NQAnh2425/SmartGarden/smart_garden_report/document/z7949874672636_2bea79ddac5231fc07fe2b95ad121b33.jpg

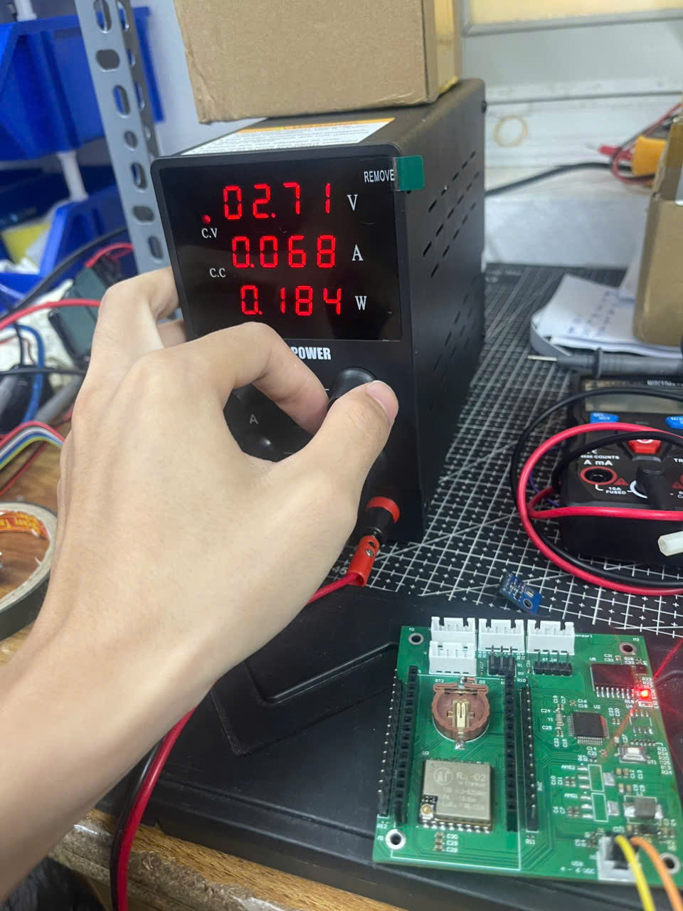
smart_garden_report/document/z7949874672636_2bea79ddac5231fc07fe2b95ad121b33.jpg
