NQAnh2425/SmartGarden/smart_garden_report/document/z7949874676888_7535db27ef83c04990b1f25cf6fda284.jpg

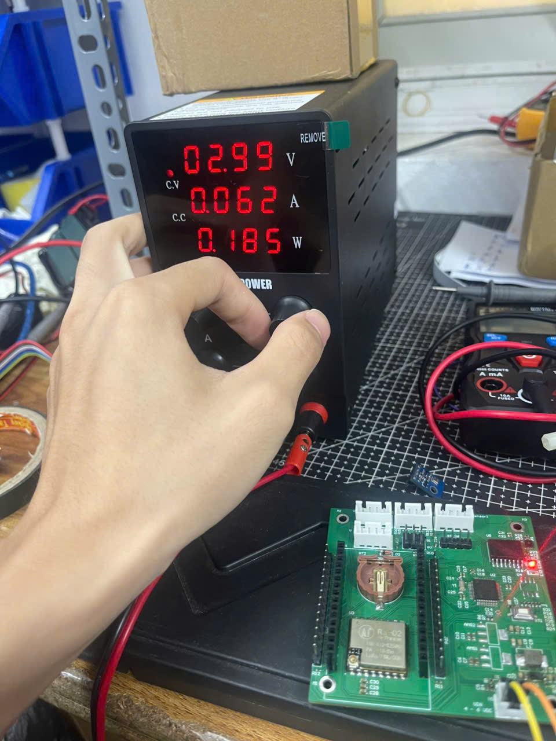
smart_garden_report/document/z7949874676888_7535db27ef83c04990b1f25cf6fda284.jpg
