NQAnh2425/SmartGarden/smart_garden_report/document/z7949874697322_e2b428432fa8df952e352a67de80ceb8.jpg

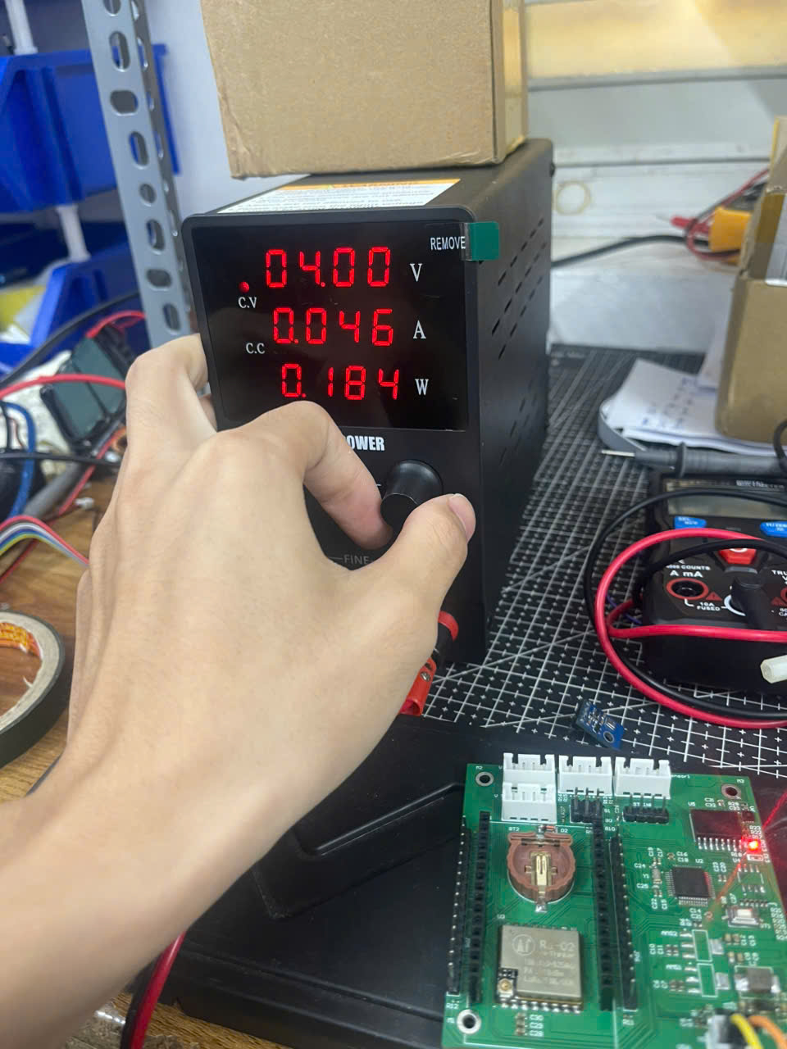
smart_garden_report/document/z7949874697322_e2b428432fa8df952e352a67de80ceb8.jpg
