NQAnh2425/SmartGarden/smart_garden_report/document/z7949874712150_3ca1921e6f091ef7c55d4dc10afe0f25.jpg

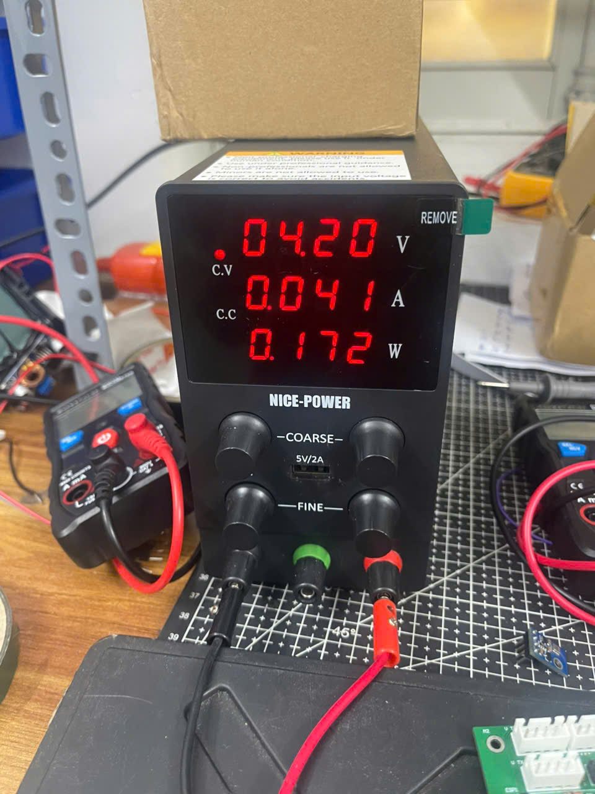
smart_garden_report/document/z7949874712150_3ca1921e6f091ef7c55d4dc10afe0f25.jpg
