NQAnh2425/SmartGarden/smart_garden_report/document/z7949874716990_c0b9dc836de0033d741a48ff5960702d.jpg

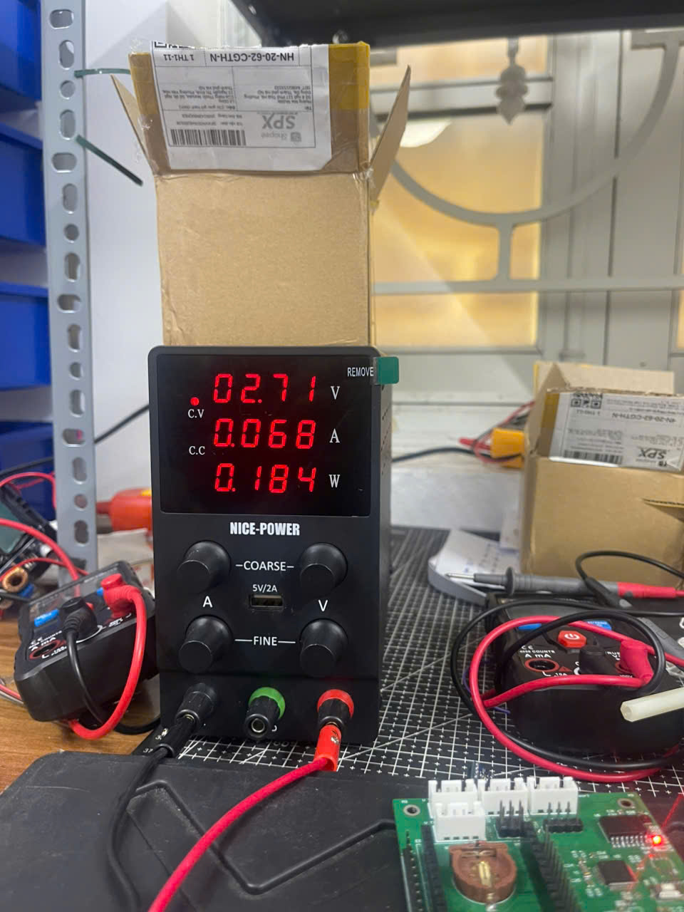
smart_garden_report/document/z7949874716990_c0b9dc836de0033d741a48ff5960702d.jpg
