NQAnh2425/SmartGarden/smart_garden/Node/Core/Src/main.c

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
/* Includes ------------------------------------------------------------------*/
#include "main.h"

/* USER CODE BEGIN Includes */
#include "string.h"
#include "SHT30.h"
#include "LoRa.h"
#include "LoRa_network.h"
#include "node.h"


/* USER CODE END Includes */

/* USER CODE BEGIN PD */
#define NODE_ID  2

#if (NODE_ID == 1)
	#define TIME_SPACE_TX 1400
    #define PRESCALER 39999

#elif (NODE_ID == 2)
	#define TIME_SPACE_TX 900
    #define PRESCALER 39350

#elif (NODE_ID == 3)
	#define TIME_SPACE_TX 1200
    #define PRESCALER 39350
#else
    #define PRESCALER 39999
#endif
/* USER CODE END PD */

I2C_HandleTypeDef hi2c1;

RTC_HandleTypeDef hrtc;

SPI_HandleTypeDef hspi1;

TIM_HandleTypeDef htim2;

UART_HandleTypeDef huart1;

/* USER CODE BEGIN PV */
volatile uint8_t Alarm_flag=0;

volatile uint8_t Rx_done_flag=0;

volatile uint8_t node_id= NODE_ID;

volatile uint8_t beacon_received_flag=0;

uint8_t missed_count=0;

LoRa myLoRa;

frame_data_t frame;

node_state_t stt;

Date date;

uint8_t data_buff[9];

RTC_TimeTypeDef Time;

uint32_t error=0;

/* USER CODE END PV */

void SystemClock_Config(void);
static void MX_GPIO_Init(void);
static void MX_I2C1_Init(void);
static void MX_SPI1_Init(void);
static void MX_USART1_UART_Init(void);
static void MX_RTC_Init(void);
static void MX_TIM2_Init(void);
/* USER CODE BEGIN 0 */
void HAL_RTC_AlarmAEventCallback(RTC_HandleTypeDef *hrtc)
{
	Alarm_flag=1;
}

void HAL_GPIO_EXTI_Callback(uint16_t GPIO_Pin){
	if(GPIO_Pin==LORA_DIO0_Pin){
		Rx_done_flag=1;
	}
}

volatile uint8_t Timer_flag = 0;

void HAL_TIM_PeriodElapsedCallback(TIM_HandleTypeDef *htim)
{
    static uint16_t cnt = 0;

    if(htim->Instance == TIM2)
    {
        if(++cnt >= 200)
        {
            cnt = 0;
            Timer_flag = 1;
        }
    }
}
/* USER CODE END 0 */

/**
  * @brief  The application entry point.
  * @retval int
  */
int main(void)
{
  /* USER CODE BEGIN 1 */
Clear_Frame(&frame);
data_buff[0]=UID;
RTC_init(&date, 55, 1, 9, 4, 4, 6, 26);
  /* USER CODE END 1 */

  /* MCU Configuration--------------------------------------------------------*/

  /* Reset of all peripherals, Initializes the Flash interface and the Systick. */
  HAL_Init();

  /* Configure the system clock */
  SystemClock_Config();

  /* Initialize all configured peripherals */
  MX_GPIO_Init();
  MX_I2C1_Init();
  MX_SPI1_Init();
  MX_USART1_UART_Init();
  MX_RTC_Init();
  MX_TIM2_Init();
  /* USER CODE BEGIN 2 */

  RTC_write_data(&hi2c1, &date, DS3231_ADDR);

  if((node_id<=16)&&(node_id>0))
  {
	  flash_write_node_id((uint16_t)node_id);
  }

LoRa_Init:

  Node_LoRa_Init(&myLoRa, &hspi1);

  Node_LoRa_Check(&stt, &myLoRa);

  RTC_read_data(&hi2c1, &date, DS3231_ADDR);

  RTC_SetTime(&hrtc, &date, RTC_FORMAT_BIN);

  RTC_SetAlarm_NextPeriod(&hrtc, 120, RTC_FORMAT_BIN);

  node_id = Node_Read_Dev_ID(&frame);

  if(node_id){
	  data_buff[0]=node_id;
  }

  /* USER CODE END 2 */

  /* Infinite loop */
  /* USER CODE BEGIN WHILE */
  while (1)
  {
	  if(Alarm_flag||Rx_done_flag||Timer_flag)
	  {
		  switch(stt)
		  {
		  case(INIT_FAIL):
				  Alarm_flag = 0;
			  for(int i=0;i<=20;i++){
				  HAL_GPIO_TogglePin(GPIOC, GPIO_PIN_13);
				  HAL_Delay(400);
			  }
			  goto LoRa_Init;

		  case(INIT_SUCCESS):
				  Alarm_flag = 0;
		  // set timeout for RX init
		  HAL_RTC_GetTime(&hrtc, &Time,0);
		  RTC_read_data(&hi2c1, &date, DS3231_ADDR);
		  RTC_SetTime_Calib(&hrtc, &hi2c1, &date, RTC_FORMAT_BIN);
		  error=RTC_get_error(&hrtc, &hi2c1, &date, 0)*1000;
		  uint32_t tick=HAL_GetTick();
		  if(error>0){
		  while((HAL_GetTick()-tick)<error)
		  {
			  ;
		  }
		  }
		  HAL_RTC_GetTime(&hrtc, &Time,0);
		  	  	  if(RTC_SetAlarm(1,&hrtc,RTC_FORMAT_BIN)==1)
		  	  	  {
				  	  	  stt = RX_BEACON_INIT;
						  break;
		  	  	  }
		  	  	  stt= INIT_FAIL;
		  	  	  break;

		  case RX_BEACON_INIT:
			  Alarm_flag=0;
			  // use gettick because RTC change value in beacon receive routine (alarm is not exact)
			  __HAL_TIM_SET_COUNTER(&htim2, 0);
			  HAL_TIM_Base_Start_IT(&htim2);
		      Node_RxCONTIN_Init(&myLoRa);
		      stt = RX_BEACON;
		      break;

		  case(RX_BEACON):
				  if(Rx_done_flag)
				  {
					  Rx_done_flag=0;
					  if(Node_Rx_Frame(&myLoRa,&frame))
					  {
						  if(frame.type==FRAME_TYPE_BEACON)
						  {
							  LoRa_gotoMode(&myLoRa, STNBY_MODE);
							  if(Node_Rx_Beacon_Handle(&frame, &hi2c1, &date, &hrtc))
								  {
								  HAL_GPIO_WritePin(GPIOC, GPIO_PIN_13,1);
								  beacon_received_flag=1;
								  if(missed_count==1)
								  {
									  missed_count=0;
									  RTC_SetAlarm(2, &hrtc, 0);
									  RTC_read_data(&hi2c1, &date, DS3231_ADDR);
									  HAL_RTC_GetTime(&hrtc, &Time, 0);
							  	  	  stt=SLEEP_TO_NEXT_PERIOD;
									  break;
								  }
						  	  	  stt=RX_BEACON;
								  break;
								  }
						  }
					  }
					  break;
				  }
		    if(Timer_flag)
		    {
		    	Timer_flag =0;
		    	HAL_TIM_Base_Stop_IT(&htim2);
		        LoRa_gotoMode(&myLoRa, STNBY_MODE);
		        RTC_SetAlarm(1, &hrtc,0);
	  	  		RTC_read_data(&hi2c1, &date, DS3231_ADDR);
	  			HAL_RTC_GetTime(&hrtc, &Time,0);
		        stt = GET_DEV_ID;
		        break;
		    }

		    if(Alarm_flag)
		    {
		    	Alarm_flag=0;
		        LoRa_gotoMode(&myLoRa, STNBY_MODE);
		        RTC_SetAlarm(1, &hrtc,0);
	  	  		RTC_read_data(&hi2c1, &date, DS3231_ADDR);
	  			HAL_RTC_GetTime(&hrtc, &Time,0);
		        stt = GET_DEV_ID;
		        break;
		    }


		  case GET_DEV_ID:
		  	  	  	Alarm_flag=0;
		  	  	  	RTC_SetAlarm(2, &hrtc,0);
		  	  	  	node_id = Node_Read_Dev_ID(&frame);

		  	  	  	if((node_id<=16)&&(node_id>0))
		  	  	  	{
		  	  	  		stt= JOINED;
		  	  	  		break;
		  	  	  	}
		  	  	  	else
		  	  	  	{
		  	  	  		stt= UNJOINED;
		  	  	  		break;

		  	  	  	}
		  case(JOINED):
				  	  Alarm_flag=0;
				  	  if(beacon_received_flag==0)
				  	  {
					  		missed_count=1;
					  		RTC_SetAlarm(110, &hrtc,0);
					  		LoRa_gotoMode(&myLoRa, RXCONTIN_MODE);
					  		stt=RX_BEACON;
				  	  	  break;
				  	  }
				  	  else
				  	  {
					  	RTC_SetAlarm(1, &hrtc,0);
				  		beacon_received_flag=0;
				  		  stt=MEASURE;
				  		  break;
				  	  }

		  case(UNJOINED):
				  	  Alarm_flag=0;
				  	  if(beacon_received_flag==0)
				  	  {
				  		missed_count=1;
				  		RTC_SetAlarm(60, &hrtc,0);
				  		LoRa_gotoMode(&myLoRa, RXCONTIN_MODE);
				  		stt=RX_BEACON;
				  	  	  break;
				  	  }
				  	  else
				  	  {
				  		RTC_SetAlarm(1, &hrtc,0);
				  		beacon_received_flag=0;
				  		  stt=TX_JOIN_REQUEST;
				  		  break;
				  	  }


		  case(TX_JOIN_REQUEST):
				  Alarm_flag = 0;
		  RTC_read_data(&hi2c1, &date, DS3231_ADDR);
		  HAL_RTC_GetTime(&hrtc, &Time,0);
		 	RTC_SetAlarm(7, &hrtc,0);
		 	Create_Frame(&frame, join_request_frame, data_buff);
		 	if (Node_Create_Payload(&frame, join_request_frame))
		 	{
			  uint32_t time_start= HAL_GetTick();
			  uint8_t Tx_count= 1;
			  while(((Tx_count-6)!=0)){
			  if(HAL_GetTick()-time_start >=1400*Tx_count){
				  Tx_count++;
				  Node_Tx_JoinRequest(&myLoRa, 1000);
			  	  	  }
			  	  }
		 	}
		 	stt=RX_JOIN_RESPONSE_INIT;
		 	break;

		  case(RX_JOIN_RESPONSE_INIT):
				  Alarm_flag = 0;
		  	  	  RTC_read_data(&hi2c1, &date, DS3231_ADDR);
		  	  	  RTC_SetAlarm(10,&hrtc, 0);
		  	  	  if(Node_RxCONTIN_Init(&myLoRa))
		  	  	  {
		  	  		stt= RX_JOIN_RESPONSE;
		  	  	  }
		  	  	  else{
		  	  		  stt = INIT_FAIL;
		  	  		  break;
		  	  	  }

		  case(RX_JOIN_RESPONSE):
				  if(Rx_done_flag)
				  {
					  if(Node_Rx_Frame(&myLoRa,&frame)){
						  if(frame.type==FRAME_TYPE_JOIN_RESPONSE)
						  {
							  LoRa_gotoMode(&myLoRa, STNBY_MODE);
							  stt = JOIN_RESPONSE_HANDLE;
							  break;
						  }
					  }
					  break;
				  }
		  	  	  if(Alarm_flag)
		  	  	  {
		  	  		  LoRa_gotoMode(&myLoRa,STNBY_MODE);
		  	  		  Alarm_flag=0;
		  	  		  RTC_SetAlarm(2,&hrtc, 0);
		  	  		  stt = SLEEP_TO_NEXT_PERIOD;
		  	  		  break;
		  	  	  }

		  case(JOIN_RESPONSE_HANDLE):
				  Alarm_flag=0;
		  	  	  RTC_SetAlarm(2, &hrtc,0);
		  	  	  stt= SLEEP_TO_NEXT_PERIOD;
				  Node_Rx_JoinResponse_Handle(&myLoRa,&hrtc,&frame,(uint8_t*)(&node_id));
				  stt=SLEEP_TO_NEXT_PERIOD;
				  break;

		  case(MEASURE):
				RTC_read_data(&hi2c1, &date, DS3231_ADDR);
		  	  	HAL_RTC_GetTime(&hrtc, &Time,0);
				  Alarm_flag =0;
		  	  	  RTC_SetAlarm(3, &hrtc,0);
		  	  	  if(read_sensor_to_buff(&hi2c1, data_buff, AHT30_ADDR, 6, 2000))
		  	  		  {
		  	  		  stt=SLEEP_WAIT_TIME_SLOT;
		  	  		  break;
		  	  		  }
		  	  	  if(read_sensor_to_buff(&hi2c1, data_buff, AHT30_ADDR, 6, 2000))
		  	  		  {
		  	  		  stt=SLEEP_WAIT_TIME_SLOT;
		  	  		  break;
		  	  		  }
		  	  	  else
		  	  	  {
		  	  		  data_buff[3]=1;
		  	  		  data_buff[4]=1;
		  	  		  data_buff[5]=1;
		  	  		  data_buff[6]=1;
		  	  		  stt=SLEEP_WAIT_TIME_SLOT;
		  	  		  break;
		  	  	  }
		  case(SLEEP_WAIT_TIME_SLOT):
				  Alarm_flag=0;
		  	  	  RTC_read_data(&hi2c1, &date, DS3231_ADDR);
		  	  	  if(error>=0){
		  	  	  RTC_SetAlarm_Timeslot(node_id, &hrtc, 12, FORMAT_BIN);
		  	  	  }
		  	  	  if(error<0){
		  	  	  RTC_SetAlarm_Timeslot(node_id, &hrtc, 12+error/1000, FORMAT_BIN);
		  	  	  }
		  	  	  Create_Frame(&frame, data_frame, data_buff);
		  	  	  if(Node_Create_Payload(&frame, data_frame))
		  	  	  {
		  	  		  stt = TX_DATA;
		  	  		  /* go to low power mode
		  	  		   *
		  	  		   *
		  	  		   *
		  	  		   *                     */
		  	  		  break;
		  	  	  }
		  	  	  stt= SLEEP_TO_NEXT_PERIOD;
		  	  	  break;

		  case(TX_DATA):
				Alarm_flag=0;
		  	  	RTC_read_data(&hi2c1, &date, DS3231_ADDR);
				HAL_RTC_GetTime(&hrtc, &Time,0);
  	  	  	  	RTC_SetAlarm(18, &hrtc,0);
  	  	  	  	uint32_t time_start= HAL_GetTick();
  	  	  	  	uint8_t Tx_count= 1;
  	  	  		while((Tx_count-15)!=0)
  	  	  		{
  	  	  			if(HAL_GetTick()-time_start >=TIME_SPACE_TX*Tx_count)
  	  	  			{
  	  	  				Tx_count++;
  	  	  				Node_Tx_Data(&myLoRa, 1000);
  	  	  			}
					  HAL_GPIO_TogglePin(GPIOC, GPIO_PIN_13);
  	  	  		}
  	  	  		stt= SLEEP_TO_NEXT_PERIOD;
  	  	  		break;


		  case(SLEEP_TO_NEXT_PERIOD):
				  Alarm_flag=0;
		  	  	  HAL_RTC_GetTime(&hrtc, &Time,0);
				 RTC_read_data(&hi2c1, &date, DS3231_ADDR);
				 RTC_SetTime_Calib(&hrtc, &hi2c1, &date, 0);
				  RTC_SetAlarm_NextPeriod(&hrtc, 120,0);
		  	  	  LoRa_gotoMode(&myLoRa, STNBY_MODE);
		  	  	  stt= INIT_SUCCESS;
		  	  	  break;
		  default:
			  break;

		  }
	  }

    /* USER CODE END WHILE */

    /* USER CODE BEGIN 3 */
  }
  /* USER CODE END 3 */
}

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
