NQAnh2425/SmartGarden/smart_garden/Gateway/Core/Inc/main.h

#define LORA_NSS_Pin GPIO_PIN_4
#define LORA_NSS_GPIO_Port GPIOA
#define LORA_SCK_Pin GPIO_PIN_5
#define LORA_SCK_GPIO_Port GPIOA
#define LORA_MISO_Pin GPIO_PIN_6
#define LORA_MISO_GPIO_Port GPIOA
#define LORA_MOSI_Pin GPIO_PIN_7
#define LORA_MOSI_GPIO_Port GPIOA
#define LORA_RESET_Pin GPIO_PIN_8
#define LORA_RESET_GPIO_Port GPIOB
#define LORA_DIO0_Pin GPIO_PIN_9
#define LORA_DIO0_GPIO_Port GPIOB
#define LORA_DIO0_EXTI_IRQn EXTI9_5_IRQn
