NQAnh2425/SmartGarden/smart_garden/Node/Core/Src/AHT30.h

#ifndef SRC_AHT30_H_
#define SRC_AHT30_H_

#include "main.h"

#define AHT30_ADDR 0x38

typedef struct {
	I2C_HandleTypeDef *hi2c;
	uint8_t address;
	uint16_t temp;
	uint8_t humi;
	uint8_t crc;
}AHT30;


uint8_t AHT30_calc_CRC8(uint8_t *data, uint8_t Num);
void AHT30_calc_data(uint8_t *data, uint8_t *RH, uint16_t *Temp);
uint8_t AHT30_isbusy(uint8_t *data);
uint8_t AHT30_read_data(I2C_HandleTypeDef *hi2c,uint8_t ADDR,uint8_t *pData, uint8_t data_size,uint32_t timeout);


#endif
