NQAnh2425/SmartGarden/(notices)

Notices in the files:
smart_garden/Node/Core/Inc/main.h:
Copyright (c) 2026 STMicroelectronics.
All rights reserved.
This software is licensed under terms that can be found in the LICENSE file
